dimitrit/lego-railway/docs/circuits.md

# Circuit diagrams

### RFID Controller

RFID tags are read using MFRC522 modules. The tag number and address of the RFID controller are sent to the train controller via the I2C bus. 

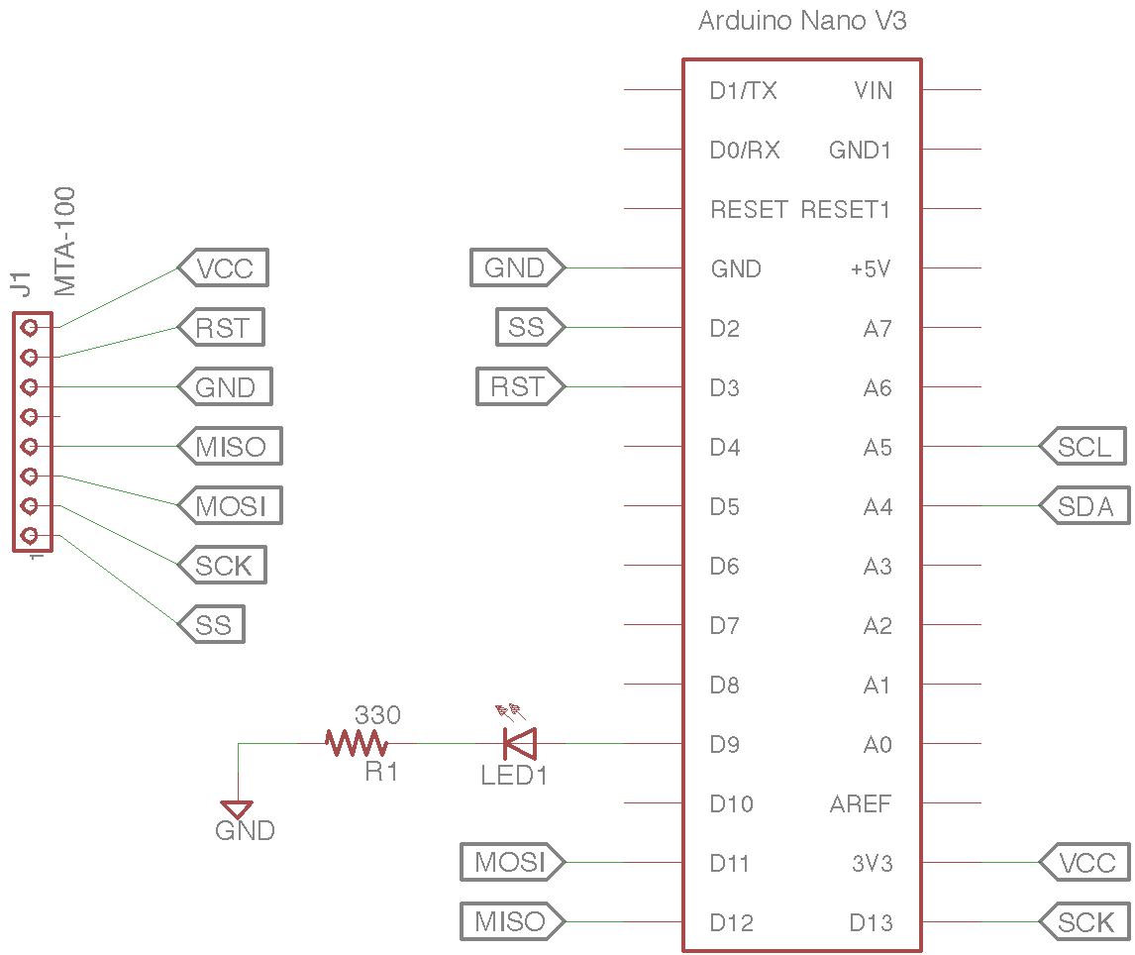
[picture p1: docs/images/rfid-schematic.png]
RFID Controller circuit diagram


### Train Controller

The train controller manages the points servos, signals, and trains.

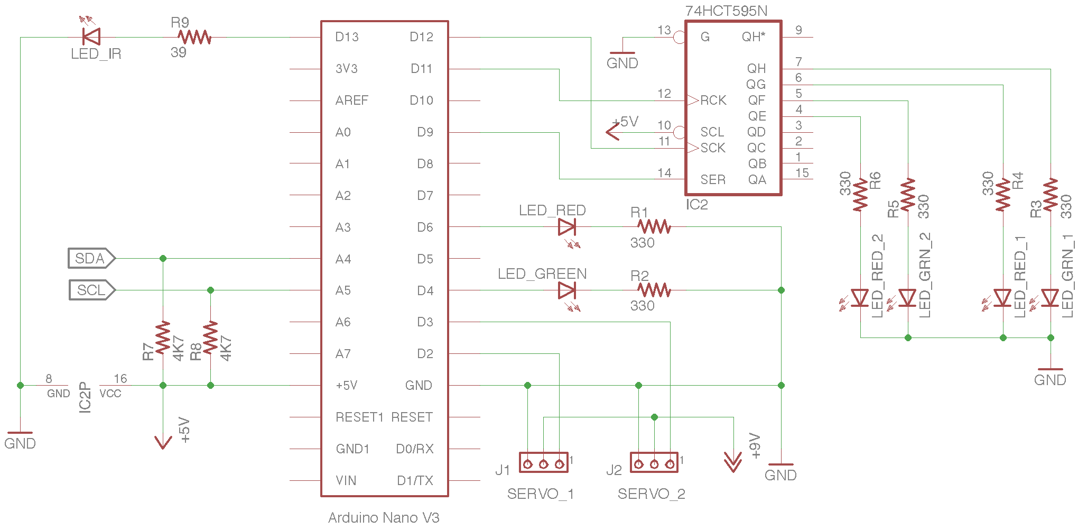
[picture p2: docs/images/controller-schematic.png]
Train Controller circuit diagram
