dimitrit/lego-railway/eagle/controller.sch

## EAGLE design eagle/controller.sch (2017-01-07)

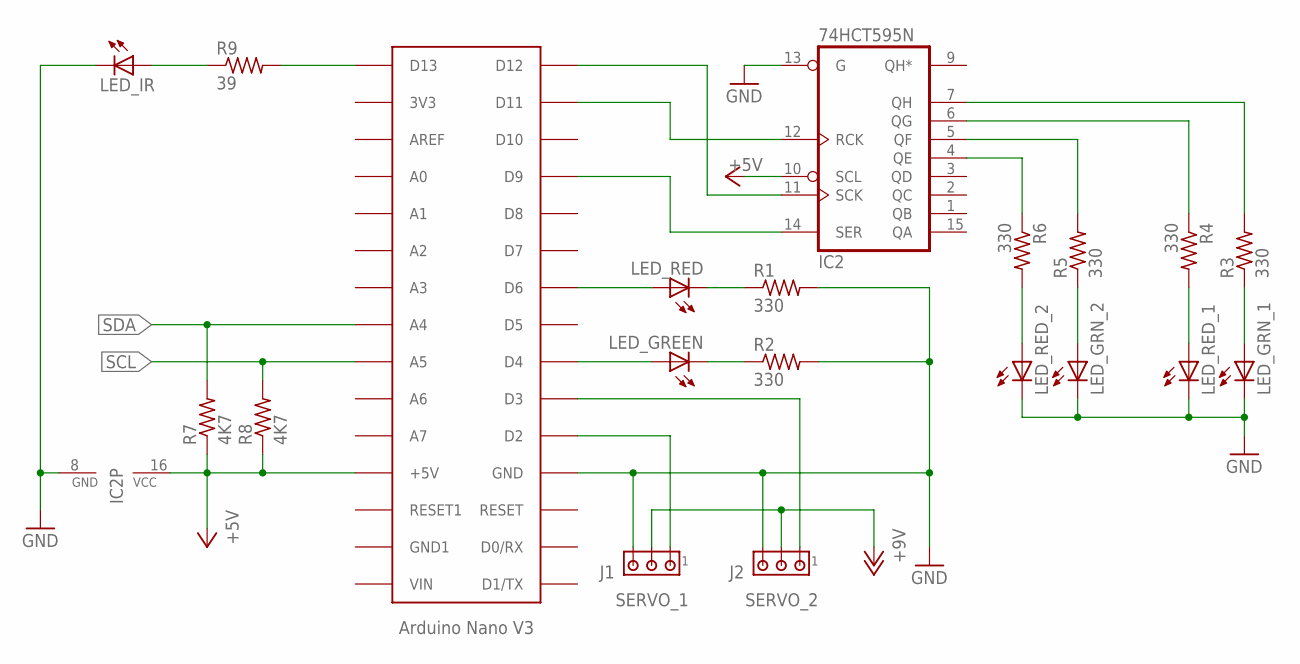
[picture p5: schematic controller.sch]

Parts:
IC2: 74HCT595N; DIL16
J1: SERVO_1; 10X03MTA
J2: SERVO_2; 10X03MTA
LED_GREEN: LED5MM
LED_GRN_1, LED_GRN_2: LED5MM
LED_IR: LED5MM
LED_RED: LED5MM
LED_RED_1, LED_RED_2: LED5MM
R1, R2, R3, R4, R5, R6: 330; 0207/10
R7, R8: 4K7; 0207/10
R9: 39; 0207/10
U$1: ARDUINONANO; PDIP-32

Connections:
+5V: IC2.10 (SCL), IC2.16 (VCC), R7.1, R8.1, U$1.+5V
+12V: J1.2, J2.2
GND: IC2.8 (GND), IC2.13 (G), J1.3, J2.3, LED_GRN_1.K (C), LED_GRN_2.K (C), LED_IR.K (C), LED_RED_1.K (C), LED_RED_2.K (C), R1.2, R2.2, U$1.GND
unnamed: IC2.14 (SER), U$1.D9
unnamed: IC2.11 (SCK), U$1.D12
unnamed: IC2.12 (RCK), U$1.D11
unnamed: LED_GREEN.A, U$1.D4
unnamed: LED_RED.A, U$1.D6
unnamed: LED_RED.K (C), R1.1
unnamed: LED_GREEN.K (C), R2.1
unnamed: LED_IR.A, R9.1
unnamed: R9.2, U$1.D13
unnamed: IC2.4 (QE), R6.1
unnamed: IC2.5 (QF), R5.2
unnamed: IC2.6 (QG), R4.1
unnamed: IC2.7 (QH), R3.2
unnamed: LED_GRN_1.A, R3.1
unnamed: LED_RED_1.A, R4.2
unnamed: LED_GRN_2.A, R5.1
unnamed: LED_RED_2.A, R6.2
unnamed: J1.1, U$1.D2
unnamed: J2.1, U$1.D3
SCL: R8.2, U$1.A2 (A5)
SDA: R7.2, U$1.A3 (A4)
