dimitrit/lego-railway/eagle/rfid.sch

## EAGLE design eagle/rfid.sch (2017-01-06)

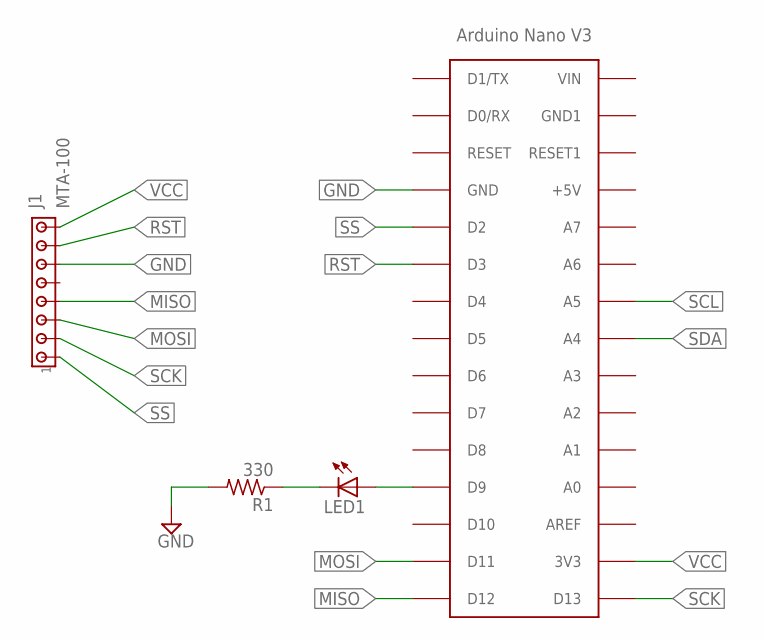
[picture p6: schematic rfid.sch]

Parts:
J1: MTA-100; 10X08MTA
LED1: LED5MM
R1: 330; 0207/10
U$1: ARDUINONANO; PDIP-32

Connections:
GND: J1.6, R1.2, U$1.GND
MISO: J1.4, U$1.D12
MOSI: J1.3, U$1.D11
unnamed: LED1.A, U$1.D9
unnamed: LED1.K (C), R1.1
RST: J1.7, U$1.D3
SCK: J1.2, U$1.D13
SCL: U$1.A2 (A5)
SDA: U$1.A3 (A4)
SS: J1.1, U$1.D2
VCC: J1.8, U$1.3V3
