dimitrit/lego-railway/(threads)

Thread 1 (2020-06-02):

link to rfid adaptor STL is broken

ciphernaut, 2020-06-02:
the link to the thingiverse entry [1] for the rfid adaptor is broken, that site now claims 404.

Please provide STL and/or source for object in this repo.

[1] http://www.thingiverse.com/thing:2020358

Thread 2 (2022-02-18):

STL files

chrisceska, 2022-02-18:
Anywhere I can download the STLs - we had them for the servo mount but kids got some new switches and need to print more - thanks
