dimitrit/lego-railway/(commit log)

2017-01-06 Update .gitignore for Eagle PCB layout tool
2017-01-06 Add schematics
    [controller.sch, rfid.sch]
2017-01-07 Clarify servo connections in schematic
    [controller.sch]
